fff-2/kasimovcup/(commit log)

2026-07-06 Add team guide page (docs/index.html) for GitHub Pages
    README에 가이드 링크 추가. Pages를 main /docs로 설정하면
    https://fff-2.github.io/kasimovcup/ 에서 바로 열람 가능.
2026-07-08 Switch to auto-start (no button) + circuit diagram + doc updates
    - main_nano: power-on = start signal, 5s countdown with LED blink
    (fix: skip status-LED write in IDLE so countdown blink is visible)
    - docs/circuit.svg: signal-focused wiring diagram (7.4V->buck 5V rail)
    - README/index.html: wiring table, match procedure, AUTO_START_MS,
    power notes (L298N VS direct-wire tip) updated to match
    [main_nano.ino]
2026-07-10 Readability fixes from visual QA pass
    - Fix callout emphasis rendering: only the title strong is block,
    inline bolds no longer break the text flow
    - Fix horizontal page scroll on mobile (grid item min-width)
    - Uniform 4:3 crop for design gallery images
